BEelzeBub5656/Machine_Clock/电源板/BOM_接线指南_v3.md

# 机械时钟电源板 v3.0 — BOM + 接线指南 (30x SG90 / 10A)

## 设计文件

```
D:\AAAend\STM32\丁真时钟\电源板\
├── 机械时钟电源板_v3_原理图.json      # EasyEDA 原理图
├── 机械时钟电源板_v3_PCB.json         # EasyEDA PCB (65x50mm)
├── 机械时钟电源板_v3_完整工程.zip      # 导入 LCEDA Pro
├── 电源板_v3_原理图.svg               # 浏览器可看的原理图
├── gen_v3.py                         # 生成脚本
└── BOM_接线指南_v3.md                 # 本文件
```

## v3.0 vs v2.0 主要变化

| 项目 | v2.0 | v3.0 |
|---|---|---|
| 舵机数量 | ~6个 | **30个** |
| 舵机轨电流 | 3A | **10A** |
| L1 电感 | 10μH/3A 工字 | **10μH/≥10A 环形** |
| J1/J2 端子 | 排针 2.54mm | **KF128 螺丝端子** |
| 舵机轨走线 | 8mil (0.2mm) | **20单位 (5mm)** |
| 铜厚 | 1oz | **2oz** |
| 板尺寸 | 45×38mm | **65×50mm** |
| 输出 | 2x5V + 1x3.3V | **3x5V + 2x3.3V + 4xGND** |

## BOM (采购清单)

| 编号 | 元件 | 规格 | 封装/尺寸 | 数量 | 约价 |
|---|---|---|---|---|---|
| J1 | KF128-2P 螺丝端子 | 5.08mm 间距, 15A | 直插 | 1 | ¥1.5 |
| J2 | KF128-2P 螺丝端子 | 5.08mm 间距, 15A | 直插 | 1 | ¥1.5 |
| J4 | 排针 1×2P | 2.54mm 公头 | 直插 | 1 | ¥0.2 |
| J5 | 排针 1×2P | 2.54mm 公头 | 直插 | 1 | ¥0.2 |
| J3 | 排针 1×2P | 2.54mm 公头 | 直插 | 1 | ¥0.2 |
| J6 | 排针 1×2P | 2.54mm 公头 | 直插 | 1 | ¥0.2 |
| L1 | 环形功率电感 | 10μH / ≥10A | 16mm径, 脚距~8mm | 1 | ¥3 |
| C1 | 电解电容 | 470μF / 16V | 10mm径, 脚距5mm | 1 | ¥0.5 |
| C2 | 电解电容 | 100μF / 16V | 6.3mm径, 脚距2.5mm | 1 | ¥0.3 |
| C3 | 电解电容 | 10μF / 10V | 5mm径, 脚距2mm | 1 | ¥0.2 |
| C4,C5 | MLCC | 0.1μF (104) | 0805 贴片 | 2 | ¥0.1 |
| U1 | 排母 1×3P | 2.54mm | 直插 | 1 | ¥0.3 |
| — | AMS1117-3.3V模块 | 你手头那个 | 25×11mm 3脚排针 | 1 | 已有 |
| — | PCB | 65×50mm 双面板 2oz | JLC打样 | 5片 | ¥8 |

**合计约 ¥8 (不含PCB打样)**

## 接线图

```
                    你的电源 PCB v3.0 (65×50mm)
                    ╔══════════════════════════════╗
    LRS +V红 ───→  ║ J1 5V_IN    [KF128螺丝端子]  ║
    LRS -V黑 ──→  ║ J1 GND      [KF128螺丝端子]  ║
                    ║                              ║
                    ║  [LC滤波 10A]                ║
                    ║  10μH环形 → 470μF           ║
                    ║                              ║
                    ║  [AMS1117模块 插排母上]       ║
                    ║                              ║
    舵机动力 ────→  ║ J2 5V_SERVO [KF128螺丝端子]  ║──→ PCA9685 #1+#2 V+
    舵机GND ────→   ║ J2 GND      [KF128螺丝端子]  ║──→ PCA9685 #1+#2 GND
                    ║                              ║
    备用5V ────→    ║ J5 5V_SPARE [排针2P]         ║
                    ║                              ║
    逻辑5V ────→    ║ J4 5V_LOGIC [排针2P]         ║──→ PCA9685 VCC + ASRPRO
                    ║                              ║
    单片机 ────→    ║ J3 3.3V OUT [排针2P]         ║──→ STM32 3.3V
                    ║                              ║
    备用3.3V ──→    ║ J6 3.3V SP   [排针2P]         ║
                    ╚══════════════════════════════╝
```

### 详细连接

| 电源板端子 | 连接器类型 | 线径 | 焊到 | 备注 |
|---|---|---|---|---|
| J1 +V, -V | KF128螺丝端子 | ≥1.5mm² | LRS-50-5 +V/-V | 电源总输入 10A |
| J2 +V, -V | KF128螺丝端子 | ≥1.5mm² | PCA9685#1 + PCA9685#2 V+并联 | 舵机动力 ≥10A |
| J5 5V, GND | 排针 2P | 0.5mm² | 备用 5V 设备 | 舵机滤波后取电 |
| J4 5V, GND | 排针 2P | 0.5mm² | PCA9685 VCC逻辑 + ASRPRO VCC | 电感前取电 |
| J3 3.3V, GND | 排针 2P | 0.3mm² | STM32F103C8T6 3.3V | 单片机供电 |
| J6 3.3V, GND | 排针 2P | 0.3mm² | 备用 3.3V 设备 | |

### GND 分配 (4个GND输出)

| GND引脚 | 来自 | 用途建议 |
|---|---|---|
| J2-GND | KF128端子 | PCA9685舵机GND (大电流) |
| J4-GND | 排针 | PCA9685逻辑GND + ASRPRO GND |
| J3-GND | 排针 | STM32 GND |
| J6-GND | 排针 | 备用 GND |

> 所有 GND 在 PCB 底层通过铜箔实现星型一点接地，不应在外部形成地环路。

## 上电验证

| 步骤 | 测点 | 预期 |
|---|---|---|
| 1 | J1 +V | 5.0V ±0.2V |
| 2 | J2 +V (空载) | 5.0V (LC滤波后) |
| 3 | J4 +V | 5.0V |
| 4 | J3 +V | 3.30V ±0.05V |
| 5 | J6 +V | 3.30V |
| 6 | 30舵机中等负载时 J2 +V | ≥4.6V |
| 7 | 满负载运行5分钟后 AMS1117 | 手摸不烫 (<60°C) |
| 8 | 满负载运行5分钟后 L1 电感 | 温升 <20°C |

## 导入立创EDA专业版

1. 打开立创EDA专业版
2. 文件 → 导入 → 嘉立创EDA(标准版)
3. 选择 `机械时钟电源板_v3_完整工程.zip`
4. 检查封装映射 (KF128-2P, IND-TOROID-16MM 可能需要手动选封装)
5. 在PCB中确认走线宽度 (舵机轨应为5mm)
6. DRC检查
7. 导出 Gerber → 嘉立创下单 (选择 **2oz 铜厚**)

## PCB 下单参数

| 参数 | 数值 |
|---|---|
| 板厚 | 1.6mm |
| 铜厚 | **2oz** (必须) |
| 板层 | 2层 |
| 阻焊色 | 绿 |
| 表面处理 | HASL (有铅/无铅) |
| 最小线宽/距 | 6/6mil |

## 备注

- **ASRPRO 吃 5V 不是 3.3V** → 接 J4 (5V_LOGIC)
- 30个舵机分为两组，各 15 个，两块 PCA9685 的 V+ 并在一起接 J2
- L1 环形电感可在淘宝搜 "10μH 10A 环形电感" 或 "铁硅铝磁环电感"
- KF128 端子若买不到可用 KF301-2P (5.08mm) 替代
- 0805 MLCC 可换 1206 封装好焊
- 手头若已有 AMS1117-3.3V 模块（非裸片），直接插上 U1 排母即可
