BEelzeBub5656/Machine_Clock/电源板/BOM_接线指南.md

# 机械时钟电源板 v2.0 — BOM + 接线指南

## 设计文件

```
D:\AAAend\STM32\丁真时钟\电源板\
├── 机械时钟电源板_原理图.json      # EasyEDA 原理图
├── 机械时钟电源板_PCB.json         # EasyEDA PCB (45×38mm)
├── 机械时钟电源板_完整工程.zip      # 导入 LCEDA Pro 的打包文件
├── 电源板原理图.svg                # 浏览器可看的原理图
├── gen_v2.py                      # 生成脚本（可再跑）
└── BOM_接线指南.md                 # 本文件
```

## BOM（采购清单）

| 编号 | 元件 | 规格 | 封装 | 数量 | 约价 |
|---|---|---|---|---|---|
| L1 | 功率电感 | 10μH / ≥3A | 8mm工字, 脚距5mm | 1 | ¥1 |
| C1 | 电解电容 | 470μF / 16V | 10mm径, 脚距5mm | 1 | ¥0.5 |
| C2 | 电解电容 | 100μF / 16V | 6.3mm径, 脚距2.5mm | 1 | ¥0.3 |
| C3 | 电解电容 | 10μF / 10V | 5mm径, 脚距2mm | 1 | ¥0.2 |
| C4,C5 | MLCC | 0.1μF (104) | 0805 贴片 | 2 | ¥0.1 |
| U1 | 排母 | 1×3P 2.54mm 母座 | 直插 | 1 | ¥0.3 |
| — | AMS1117-3.3V模块 | 你手头那个 | 25×11mm 3脚排针 | 1 | 已有 |
| — | PCB | 45×38mm 双面板 | JLC打样 | 5片 | ¥5 |

**合计约 ¥7（不含PCB打样费）**

> 0805 MLCC 太小不好焊的话可以买 1206 封装，焊盘也能兼容。

## 接线图

```
                    你的电源 PCB (45×38mm)
                    ╔════════════════════╗
    LRS 5V红 ───→  ║ 5V_IN    [焊接]    ║
    LRS GND黑 ──→  ║ GND      [焊接]    ║
                    ║                    ║
                    ║  [LC滤波]          ║
                    ║  10μH→470μF       ║
                    ║                    ║
                    ║  [AMS1117模块]     ║
                    ║  插在排母上        ║
                    ║                    ║
                    ║ 5V_SERVO  [焊接]──→║──→ PCA9685 #1 V+ (+GND)
                    ║ GND       [焊接]──→║──→ PCA9685 #1 GND
                    ║                    ║
                    ║ 5V_LOGIC  [焊接]──→║──→ PCA9685 #1/#2 VCC (逻辑)
                    ║ GND       [焊接]──→║      + ASRPRO 5V
                    ║                    ║
                    ║ 3.3V      [焊接]──→║──→ STM32 3.3V
                    ║ GND       [焊接]──→║──→ STM32 GND
                    ╚════════════════════╝
```

### 详细连接

| 电源板焊盘 | 线径 | 焊到 | 备注 |
|---|---|---|---|
| J1 5V_IN + GND | ≥1.0mm² | LRS 5V 输出端子 | 电源总输入 |
| J2 5V_SERVO + GND | ≥1.0mm² | PCA9685 V+ 端子 + GND | 舵机电源（两块PCA9685并在一起焊） |
| J4 5V_LOGIC + GND | 0.5mm² | PCA9685 VCC脚 + ASRPRO VCC | 电感前取电，不受舵机干扰 |
| J3 3.3V + GND | 0.3mm² | STM32 3.3V脚 + GND | 单片机供电 |

### 星型接地关键规则

所有 GND 焊盘在 PCB 内已做底层铜箔汇流，但外部接线也要遵守：
- **正确的**：每个模块的 GND 分别飞线到电源板 GND 焊盘
- **错误的**：PCA9685 GND → STM32 GND → 电源板（链式接地会引入共阻抗噪声）

## 上电验证

| 步骤 | 测点 | 预期 |
|---|---|---|
| 1 | 5V_IN 焊盘 | 5.0V ±0.2V |
| 2 | 5V_SERVO 焊盘 | 5.0V（空载） |
| 3 | 5V_LOGIC 焊盘 | 5.0V |
| 4 | 3.3V 焊盘 | 3.30V ±0.05V |
| 5 | AMS1117 模块 OUT | 3.30V |
| 6 | 30舵机全翻转时 5V_SERVO | ≥4.6V |
| 7 | 运行1小时后 AMS1117 温度 | 手摸不烫（<60°C） |

## I2C 上拉电阻（在主板补焊）

PCA9685 模块没有上拉电阻。在现有主板上飞两个 4.7KΩ (1/4W)：

```
SDA排针 ──[4.7KΩ]── 3.3V排针
SCL排针 ──[4.7KΩ]── 3.3V排针
```

用 3.3V 不是 5V，因为 STM32 I/O 是 3.3V 电平。

## 导入立创EDA

1. 打开立创EDA专业版
2. 文件 → 导入 → 嘉立创EDA(标准版)
3. 选择 `机械时钟电源板_完整工程.zip`
4. 检查元件封装映射是否正确
5. 如有文本偏移手动调一下
6. 导出 Gerber → JLC 下单

## 备注

- ASRPRO 吃 5V 不是 3.3V，接 J4 (5V_LOGIC)
- DS1302 自带纽扣电池，不掉时间
- ST-Link 烧录器 3.3V 断开不用，全由 LRS 统一供
