BEelzeBub5656/Machine_Clock/(commit log)

2026-05-26 电源板v2.0: LC滤波+LDO三路输出, AMS1117模块化, 完整BOM+接线指南
2026-05-26 电源板v3.0: 65x50mm 2oz 10A舵机轨, Gerber就绪
    - 板面积 45x38 → 65x50mm, 铜厚 1oz → 2oz
    - 新增 J5(5V_SPARE) J6(3.3V_SPARE) 扩展接口
    - 舵机轨加宽至 5mm 支持 30xSG90 满载 10A
    - AMS1117 输入/输出各加 0.1uF MLCC 去耦 (C4, C5)
    - 生成标准 Gerber 可直接投板 JLC
    - 新增 gen_v3.py 生成脚本, BOM_v3 接线指南
    [PowerBoard_v3.GBL, PowerBoard_v3.GBS, PowerBoard_v3.GKO, PowerBoard_v3.GTL, PowerBoard_v3.GTO, PowerBoard_v3.GTS]
2026-05-26 添加 CLAUDE.md 项目文档，方便后续会话快速恢复上下文
2026-06-06 v2: 修复I2C ACK检测+总线恢复+显示缓存+看门狗+DS1302补偿(2秒/天)
